klaudiamalesa/iot-candy-sorter-thesis/README.md

# Projekt Inżynierski: Urządzenie IoT do sortowania cukierków według barwy

Samodzielnie zaprojektowany i zrealizowany funkcjonalny system mechatroniczny łączący mechanikę, elektronikę i informatykę.

## Wykorzystane technologie
* **Software i Algorytmy:** Python (wizualizacja w czasie rzeczywistym, archiwizowanie danych), autorski algorytm rozpoznawania barw odporny na zmienne oświetlenie (izolowana komora optyczna).
* **Sterowanie:** Arduino (logika czasu rzeczywistego, precyzyjne sterowanie automatyczne).
* **Hardware i Konstrukcja:** AutoCAD (dokumentacja i modele), KiCad (zaprojektowanie płyty PCB), fizyczny montaż układów mikrokontrolerów i czujników.

## Zawartość repozytorium
* `pracainzynierska.pdf` – Oficjalna dokumentacja projektu inżynierskiego.
* `main.py` – Aplikacja w Pythonie odpowiedzialna za wizualizację i obsługę danych.
* `kod_sorter_arduino.ino` – Skrypt sterujący mikrokontrolerem Arduino.
